turtlebasket/midi-controller/README.md

# Pocket Operator

## Contents

- [`device`](device/) - Board design files ([see README](device/README.md))
- [`firmware`](firmware/) - Device firmware ([see README](firmware/README.md))

## Gallery

| Completed Board (bird's eye) | Completed Board (top) |
| --- | --- |
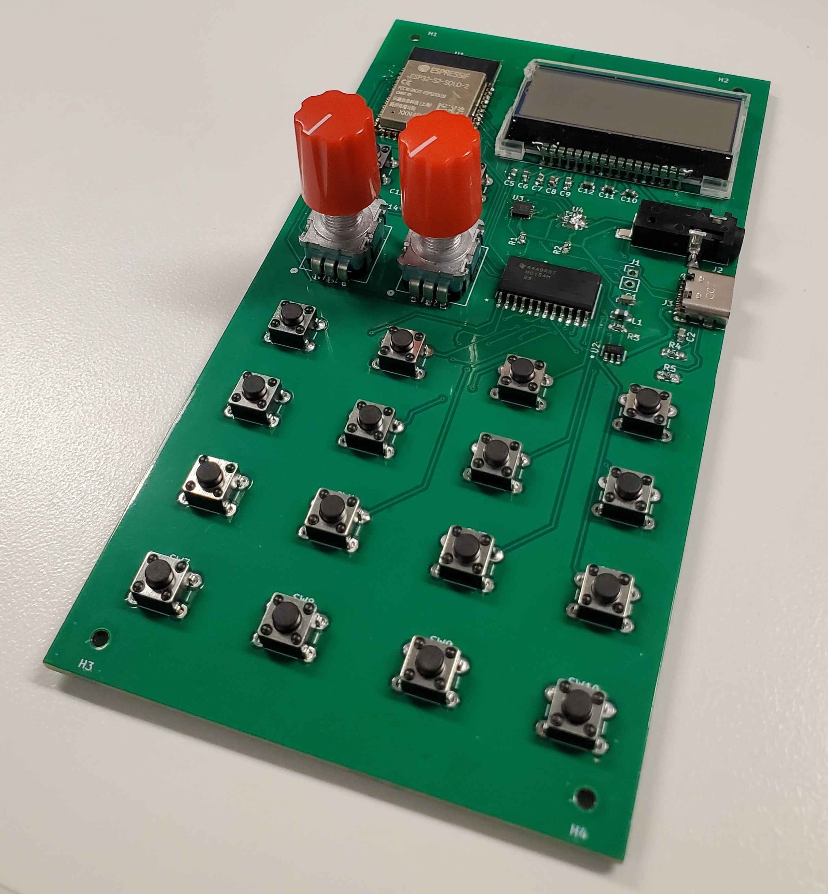
[picture p1: assets/finished-board.jpg]
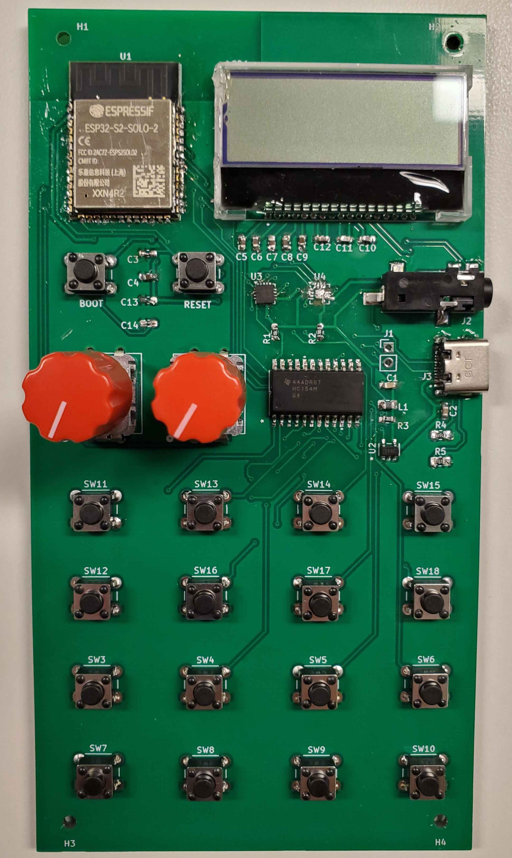
[picture p2: assets/finished-board-top.jpg]
|  |  | 

| Layout (Top) | Layout (Bottom) | Layout (Full) |
| --- | --- | --- |
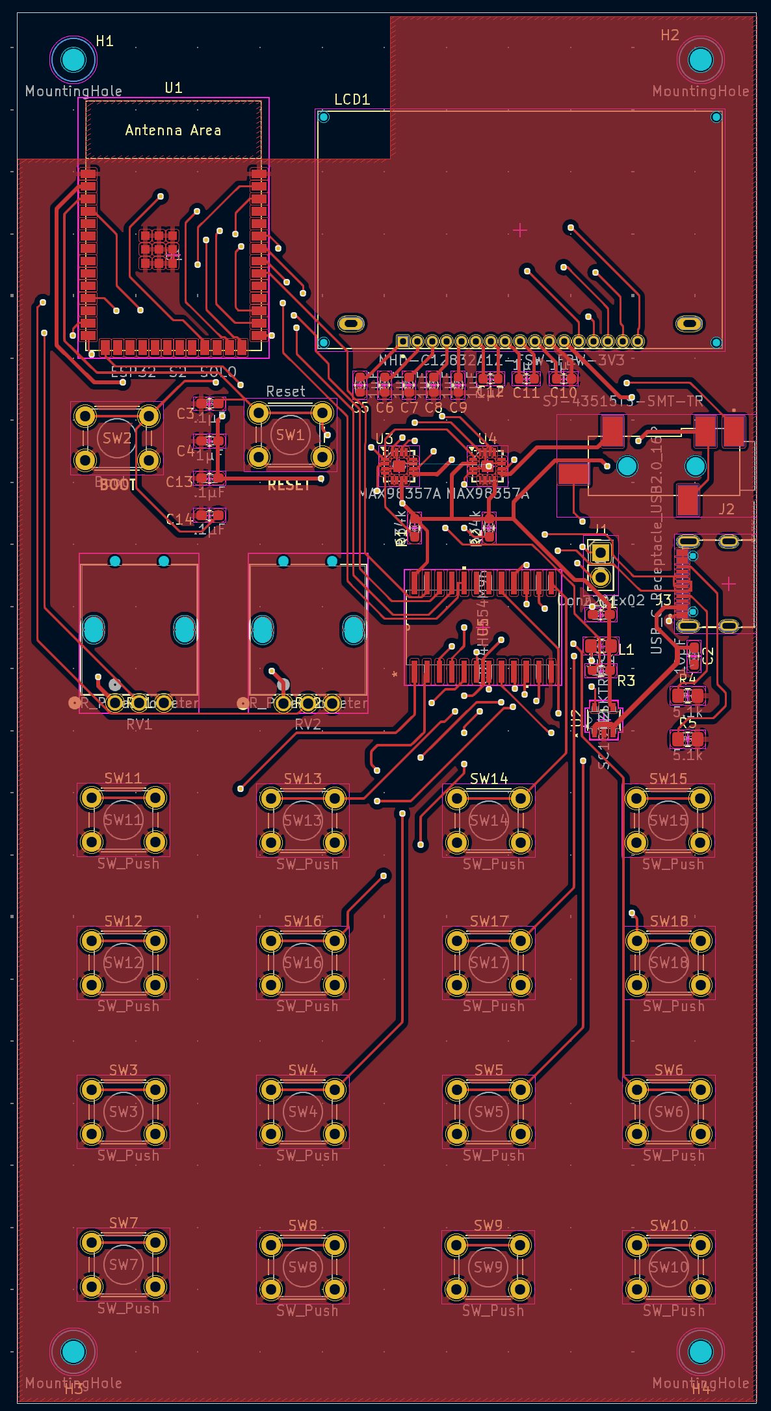
[picture p3: assets/layout-top.png]
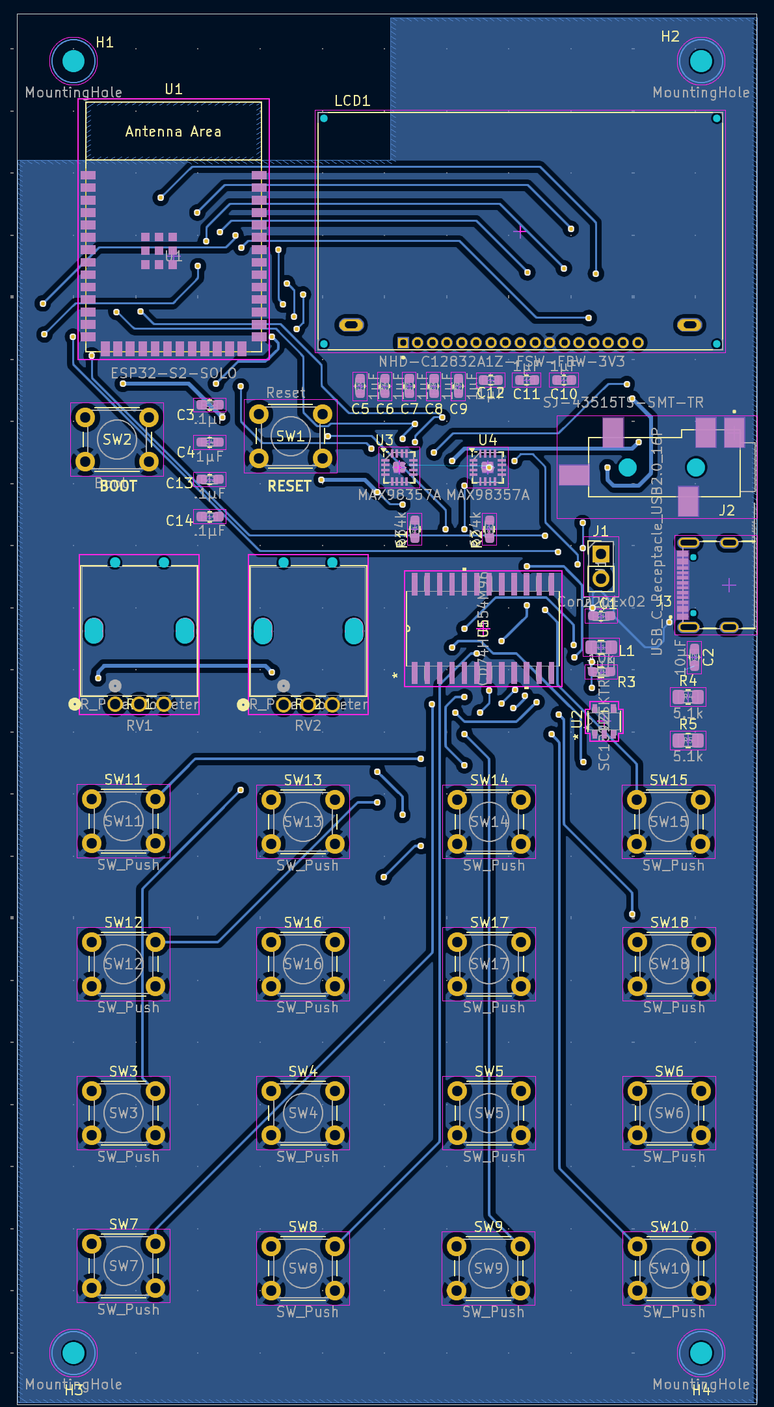
[picture p4: assets/layout-bottom.png]
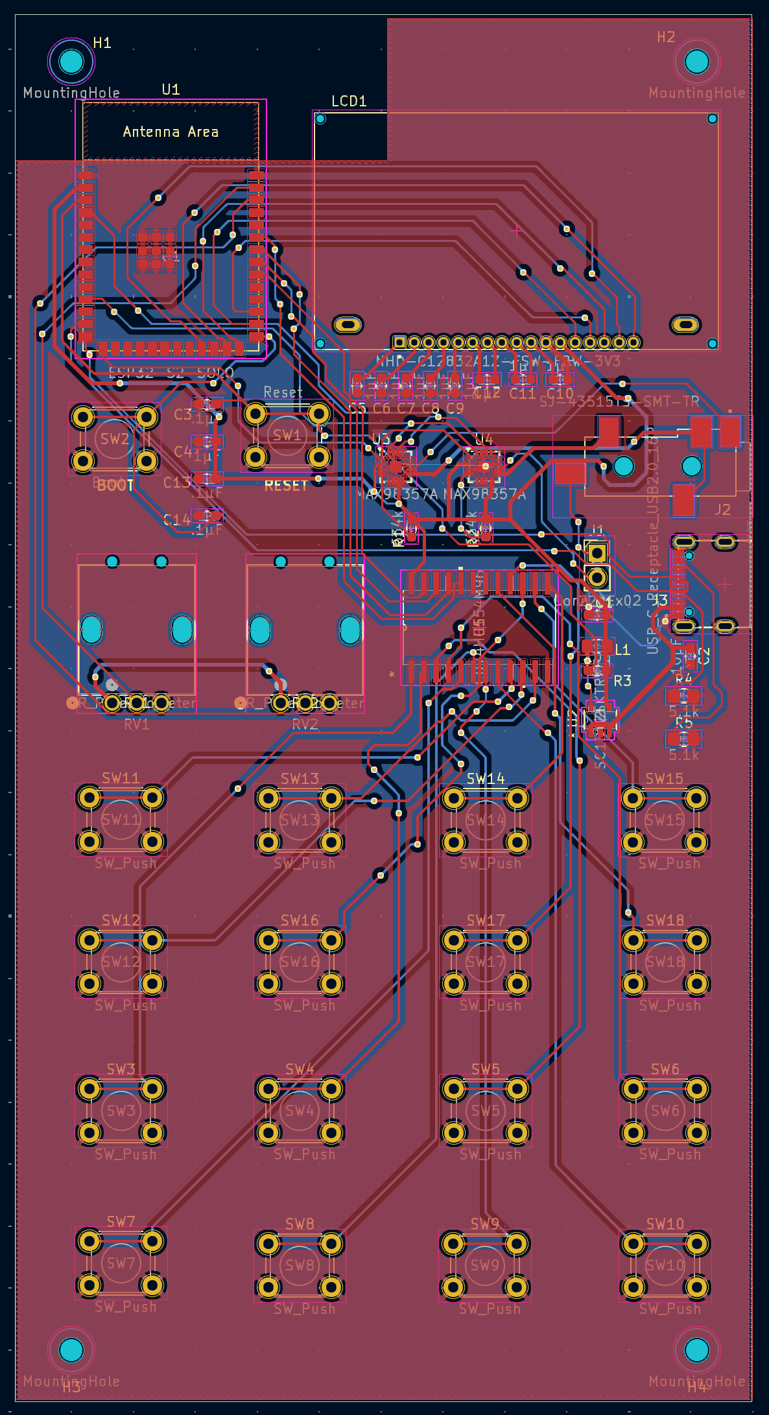
[picture p5: assets/layout-full.png]
|  |  |  |

| Schematic |
| --------- |
