turtlebasket/midi-controller/device/README.md

# Pocket Operator PCB Design Files

## Required KiCad Libraries

Must install:

- [Digikey Library](https://www.digikey.com/en/resources/design-tools/kicad) ([GitHub](https://github.com/Digi-Key/digikey-kicad-library))
- [Espressif Library (v3.0.1)](https://github.com/espressif/kicad-libraries/releases/tag/3.0.1)
