turtlebasket/midi-controller/device/parts/USB4105-GF-A/USB4105-GF-A.step

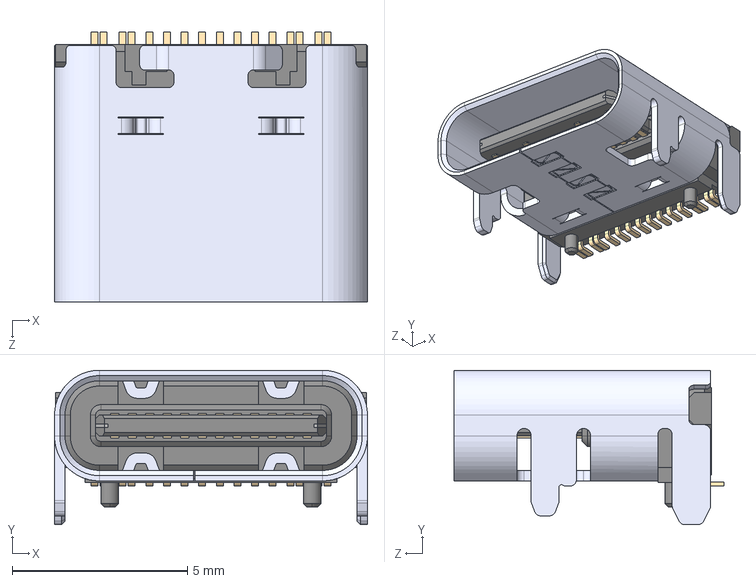
[picture p6: CAD file, 2024-11-02]
device/parts/USB4105-GF-A/USB4105-GF-A.step
8.94 x 4.41 x 7.71 mm
