turtlebasket/midi-controller/device/device.kicad_pcb

## KiCad design device/device.kicad_pcb (2024-11-08)

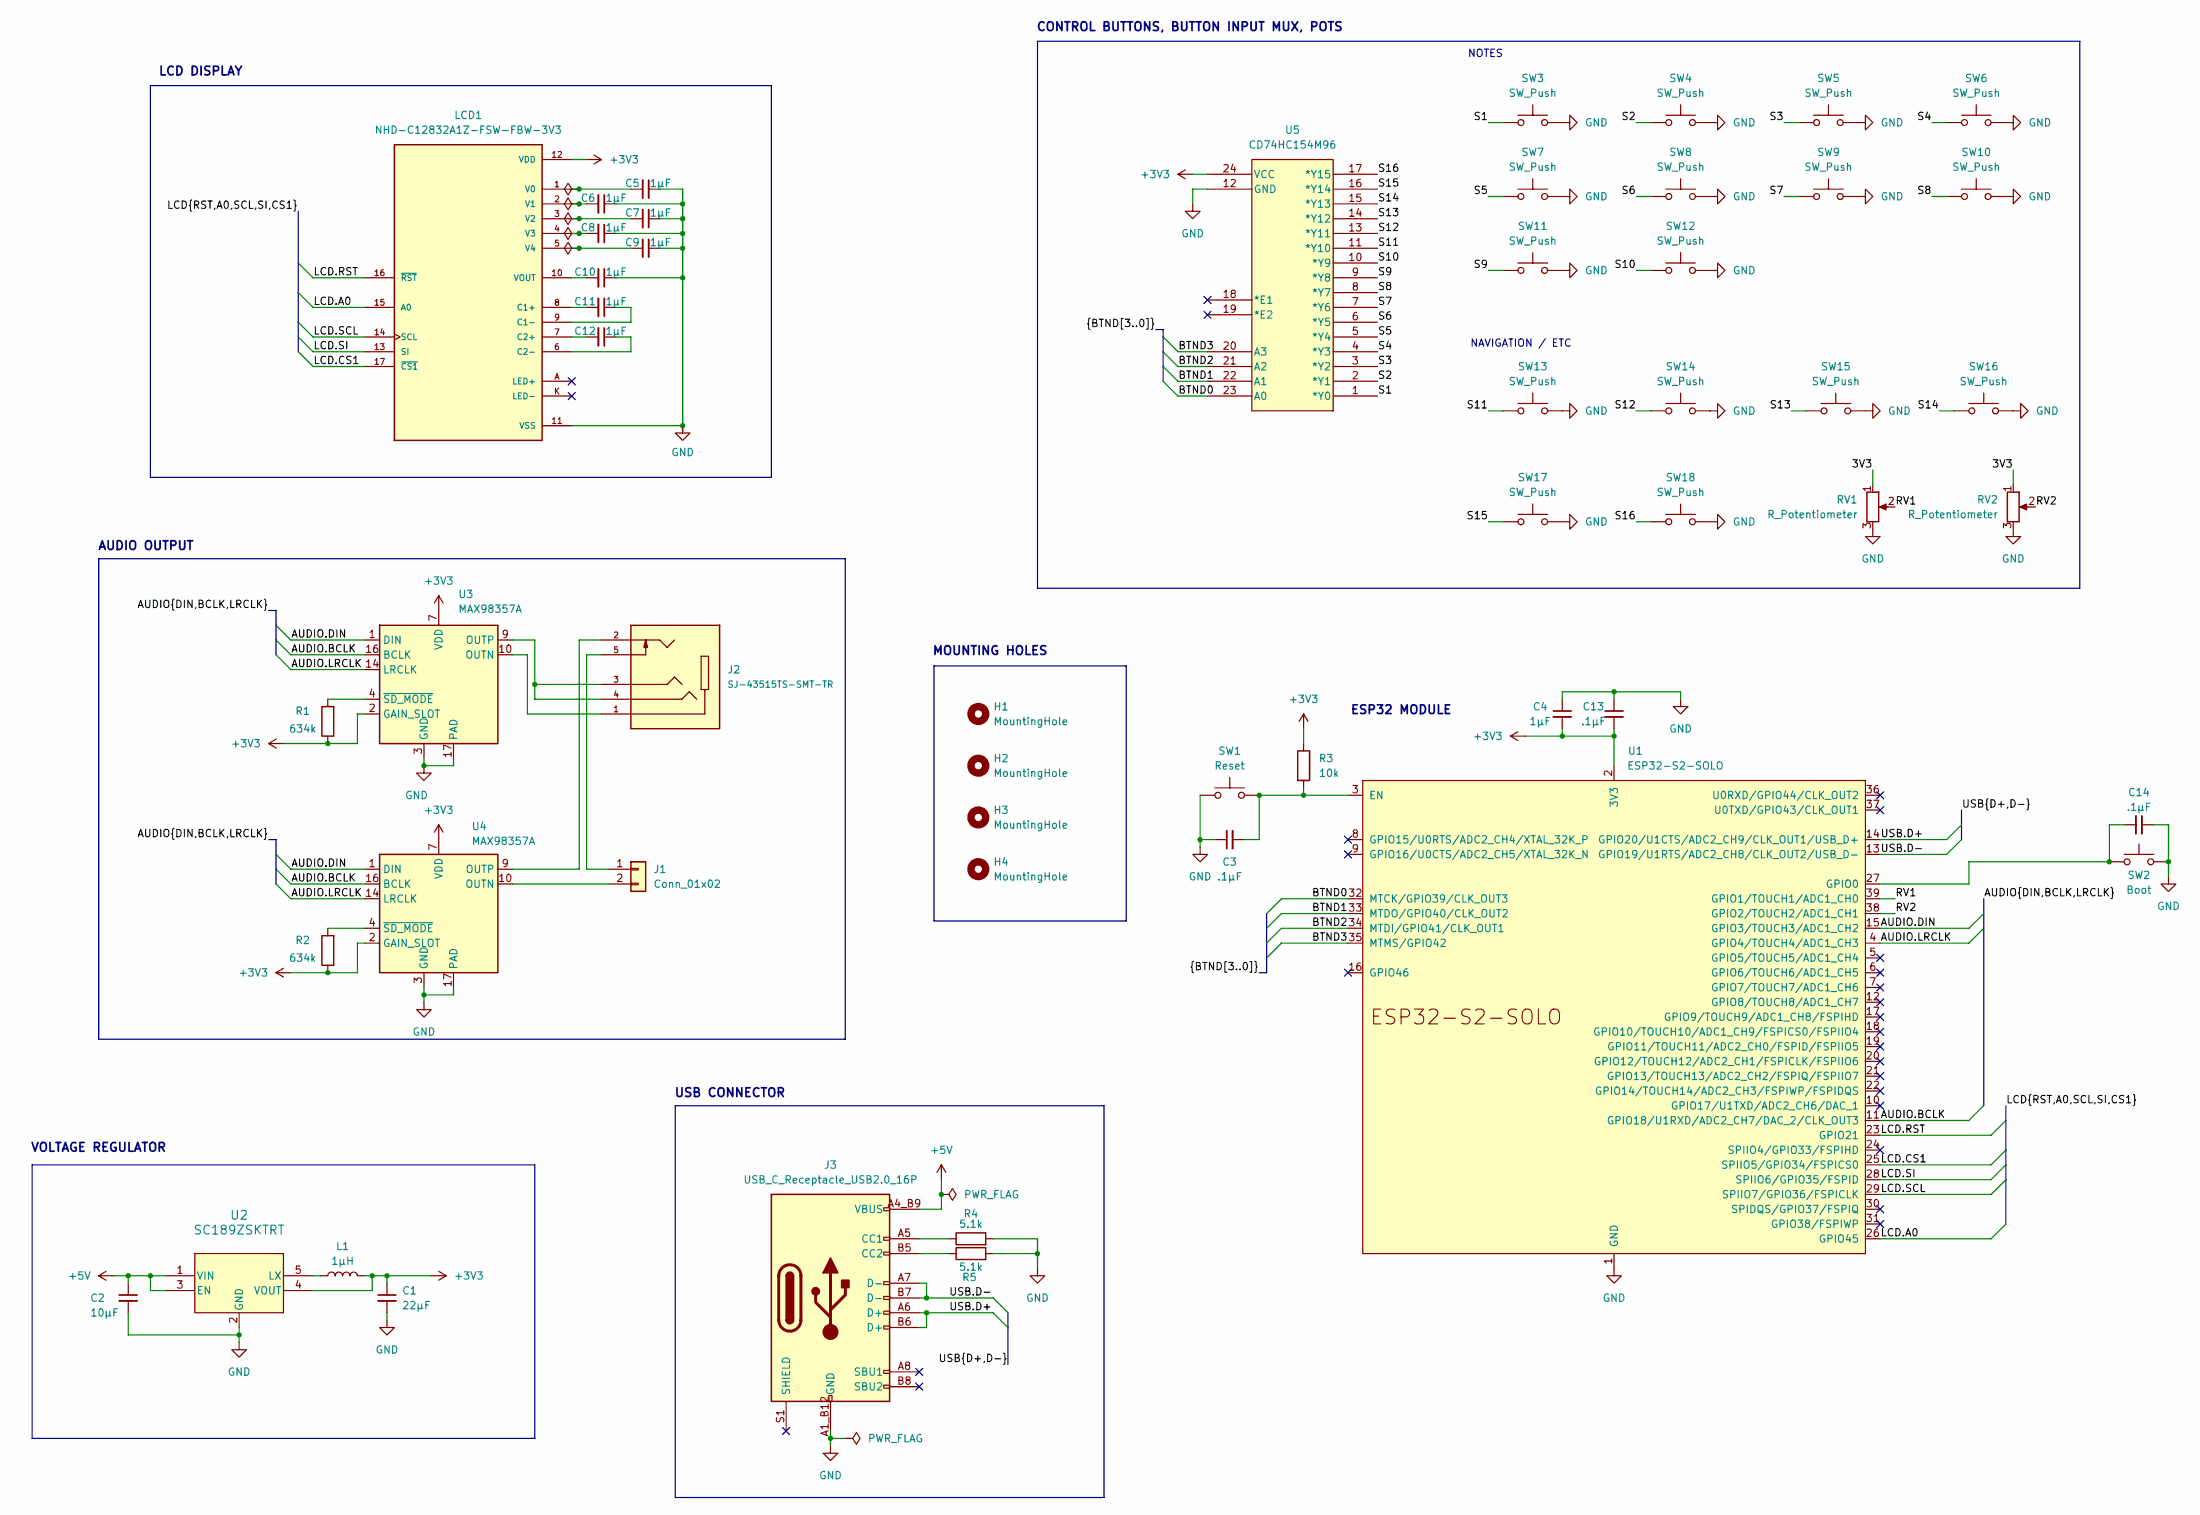
[picture p7: schematic device.kicad_sch]

Parts:
C1: 22µF; C_0603_1608Metric_Pad1.08x0.95mm_HandSolder
C2: 10µF; C_0603_1608Metric_Pad1.08x0.95mm_HandSolder
C3, C13, C14: .1µF; C_0603_1608Metric_Pad1.08x0.95mm_HandSolder
C4: 1µF; C_0603_1608Metric_Pad1.08x0.95mm_HandSolder
C5, C6, C7, C8, C9, C10, C11, C12: 1µF; C_0603_1608Metric
H1, H2, H3, H4: MountingHole; MountingHole_2.2mm_M2
J1: Conn_01x02; PinHeader_1x02_P2.54mm_Vertical
J2: SJ-43515TS-SMT-TR; CUI_SJ-43515TS-SMT-TR; PARTREV 1.05
J3: USB_C_Receptacle_USB2.0_16P; GCT_USB4105-GF-A
L1: 1µH; L_0805_2012Metric_Pad1.15x1.40mm_HandSolder
LCD1: NHD-C12832A1Z-FSW-FBW-3V3; LCD_NHD-C12832A1Z-FSW-FBW-3V3; PARTREV 7
R1, R2: 634k; R_0603_1608Metric_Pad0.98x0.95mm_HandSolder
R3: 10k; R_0603_1608Metric_Pad0.98x0.95mm_HandSolder
R4, R5: 5.1k; R_0805_2012Metric_Pad1.20x1.40mm_HandSolder
RV1, RV2: R_Potentiometer; POT_PRS11R-4-S_BRN
SW1: Reset; SW_PUSH_6mm_H5mm
SW2: Boot; SW_PUSH_6mm_H5mm
SW3, SW4, SW5, SW6, SW7, SW8, SW9, SW10, SW11, SW12, SW13, SW14, SW15, SW16, SW17, SW18: SW_Push; SW_PUSH_6mm_H5mm
U1: ESP32-S2-SOLO
U2: SC189ZSKTRT; SOT23-5-SC189_SEM
U3, U4: MAX98357A; TQFN-16-1EP_3x3mm_P0.5mm_EP1.23x1.23mm
U5: CD74HC154M96; DW24

Connections:
+3V3: C1.1, C4.2, C13.2, L1.2, LCD1.12 (VDD), R1.1, R2.1, R3.1, U1.2 (3V3), U2.4 (VOUT), U3.2 (GAIN_SLOT), U3.7 (VDD), U3.8 (VDD), U4.2 (GAIN_SLOT), U4.7 (VDD), U4.8 (VDD), U5.24 (VCC)
+5V: C2.1, J3.A4_B9 (VBUS), J3.A9 (VBUS), J3.B4 (VBUS), J3.B9 (VBUS), U2.1 (VIN), U2.3 (EN)
/3V3: RV1.1, RV2.1
/AUDIO.BCLK: U1.11 (GPIO18/U1RXD/ADC2_CH7/DAC_2/CLK_OUT3), U3.16 (BCLK), U4.16 (BCLK)
/AUDIO.DIN: U1.15 (GPIO3/TOUCH3/ADC1_CH2), U3.1 (DIN), U4.1 (DIN)
/AUDIO.LRCLK: U1.4 (GPIO4/TOUCH4/ADC1_CH3), U3.14 (LRCLK), U4.14 (LRCLK)
/BTND0: U1.32 (MTCK/GPIO39/CLK_OUT3), U5.23 (A0)
/BTND1: U1.33 (MTDO/GPIO40/CLK_OUT2), U5.22 (A1)
/BTND2: U1.34 (MTDI/GPIO41/CLK_OUT1), U5.21 (A2)
/BTND3: U1.35 (MTMS/GPIO42), U5.20 (A3)
/LCD.A0: LCD1.15 (A0), U1.26 (GPIO45)
/LCD.CS1: LCD1.17 (~CS1), U1.25 (SPIIO5/GPIO34/FSPICS0)
/LCD.RST: LCD1.16 (~RST), U1.23 (GPIO21)
/LCD.SCL: LCD1.14 (SCL), U1.29 (SPIIO7/GPIO36/FSPICLK)
/LCD.SI: LCD1.13 (SI), U1.28 (SPIIO6/GPIO35/FSPID)
/RV1: RV1.2, U1.39 (GPIO1/TOUCH1/ADC1_CH0)
/RV2: RV2.2, U1.38 (GPIO2/TOUCH2/ADC1_CH1)
/S1: SW3.1, U5.1 (*Y0)
/S2: SW4.1, U5.2 (*Y1)
/S3: SW5.1, U5.3 (*Y2)
/S4: SW6.1, U5.4 (*Y3)
/S5: SW7.1, U5.5 (*Y4)
/S6: SW8.1, U5.6 (*Y5)
/S7: SW9.1, U5.7 (*Y6)
/S8: SW10.1, U5.8 (*Y7)
/S9: SW11.1, U5.9 (*Y8)
/S10: SW12.1, U5.10 (*Y9)
/S11: SW13.1, U5.11 (*Y10)
/S12: SW14.1, U5.13 (*Y11)
/S13: SW15.1, U5.14 (*Y12)
/S14: SW16.1, U5.15 (*Y13)
/S15: SW17.1, U5.16 (*Y14)
/S16: SW18.1, U5.17 (*Y15)
/USB.D+: J3.A6 (D+), J3.B6 (D+), U1.14 (GPIO20/U1CTS/ADC2_CH9/CLK_OUT1/USB_D+)
/USB.D-: J3.A7 (D-), J3.B7 (D-), U1.13 (GPIO19/U1RTS/ADC2_CH8/CLK_OUT2/USB_D-)
GND: C1.2, C2.2, C3.1, C4.1, C5.1, C6.1, C7.1, C8.1, C9.1, C10.1, C13.1, C14.1, J3.A1_B12 (GND), J3.A12 (GND), J3.B1 (GND), J3.B12 (GND), LCD1.11 (VSS), R4.2, R5.2, RV1.3, RV2.3, SW1.1, SW2.2, SW3.2, SW4.2, SW5.2, SW6.2, SW7.2, SW8.2, SW9.2, SW10.2, SW11.2, SW12.2, SW13.2, SW14.2, SW15.2, SW16.2, SW17.2, SW18.2, U1.1 (GND), U1.40 (GND), U1.41 (GND), U2.2 (GND), U3.3 (GND), U3.11 (GND), U3.15 (GND), U3.17 (PAD), U4.3 (GND), U4.11 (GND), U4.15 (GND), U4.17 (PAD), U5.12 (GND)
unnamed: J1.1, J2.5
unnamed: J1.2, U4.10 (OUTN)
unnamed: J3.A5 (CC1), R4.1
unnamed: J3.B5 (CC2), R5.1
unnamed: C11.2, LCD1.8 (C1+)
unnamed: C11.1, LCD1.9 (C1-)
unnamed: C12.2, LCD1.7 (C2+)
unnamed: C12.1, LCD1.6 (C2-)
unnamed: C5.2, LCD1.1 (V0)
unnamed: C6.2, LCD1.2 (V1)
unnamed: C7.2, LCD1.3 (V2)
unnamed: C8.2, LCD1.4 (V3)
unnamed: C9.2, LCD1.5 (V4)
unnamed: C10.2, LCD1.10 (VOUT)
unnamed: C3.2, R3.2, SW1.2, U1.3 (EN)
unnamed: C14.2, SW2.1, U1.27 (GPIO0)
unnamed: L1.1, U2.5 (LX)
unnamed: J2.1, U3.10 (OUTN)
unnamed: J2.3, J2.4, U3.9 (OUTP)
unnamed: R1.2, U3.4 (~SD_MODE)
unnamed: J2.2, U4.9 (OUTP)
unnamed: R2.2, U4.4 (~SD_MODE)

Notes on the sheet:
VOLTAGE REGULATOR
CONTROL BUTTONS, BUTTON INPUT MUX, POTS
AUDIO OUTPUT
MOUNTING HOLES
USB CONNECTOR
NOTES
ESP32 MODULE
NAVIGATION / ETC
LCD DISPLAY

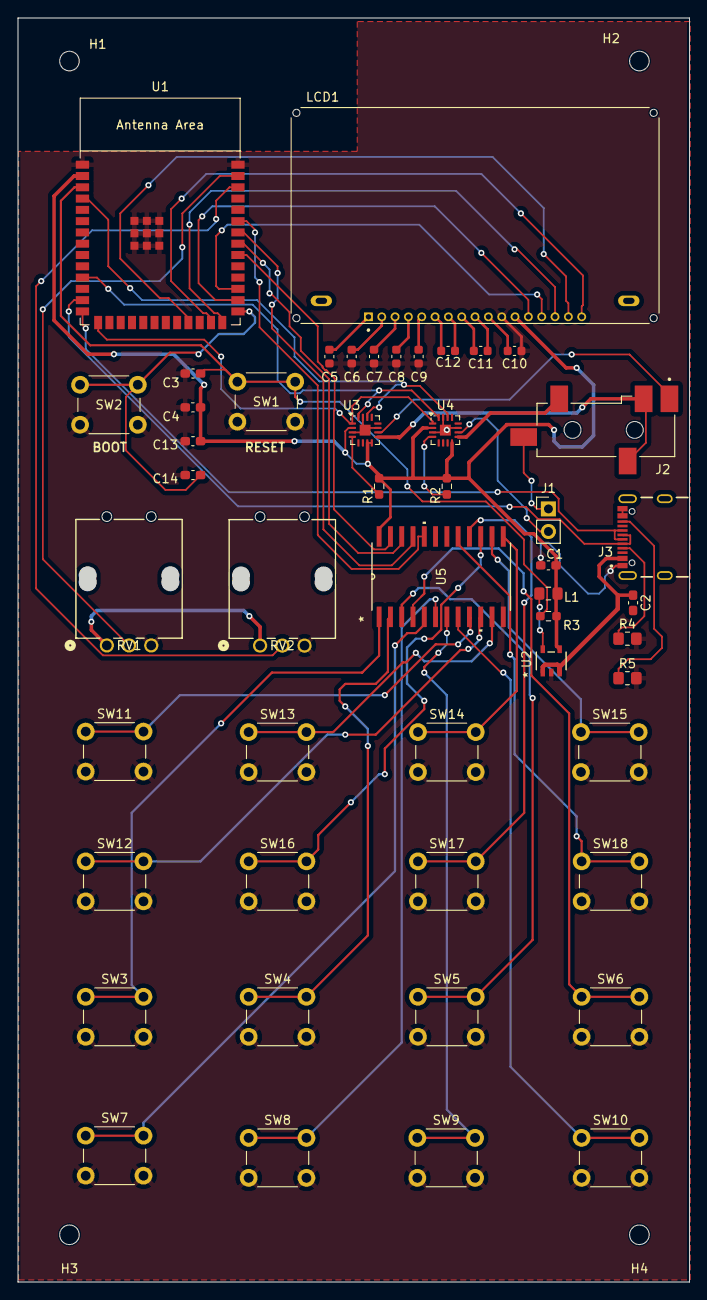
[picture p8: board device.kicad_pcb from above]

Board: 2 copper layers, 75.6 x 142.2 mm, 53 parts (0 on the bottom side), 58 nets.
