turtlebasket/midi-controller/(threads)

Thread 7 (2024-10-30):

New voltage regulator & passives (schematic)

turtlebasket, 2024-10-30:
Switch from LTC1624 to single-mode buck converter (5V->3.3V), must support  & choose new set of passives

Closed 2024-11-05.
