turtlebasket/midi-controller/(commit log)

2024-10-18 add kicad ignores
2024-10-18 move kicad ignore / ignore backups
2024-10-18 remove midi/midi.kicad_prl
2024-10-18 update esp32 from s2 to s3
    [ESP32-S3.step]
2024-10-18 use esp32-s3-wroom
    [ESP32-S3.step]
2024-10-18 button/potentiometer layout
    [midi.kicad_sch]
2024-10-18 add vreg schematic symbol
2024-10-19 added LTC1624 symbol, button layout, working on voltage reg
    [midi.kicad_sch]
2024-10-19 finished voltage regulator
    [midi.kicad_sch]
2024-10-19 page size increase and loaded screen
    [midi.kicad_sch]
2024-10-20 schematic: link up audio i2s & LCD SPI bus
    [midi.kicad_sch]
2024-10-21 add button input mux
    [midi.kicad_sch]
2024-10-21 remove old voltage regulator
2024-10-30 added footprints for caps and some others
    [midi.kicad_sch]
2024-10-30 downloaded mosfet footprint, tried to import footprint libs but failed
2024-10-30 downloaded L1 footprint
    [midi.kicad_sch]
2024-10-30 can't get footprint import to work
    [midi.kicad_sch]
2024-10-30 unfuck footprint assignments / significant progress on layout
    [midi.kicad_pcb, midi.kicad_sch]
2024-10-30 switch esp32 from s3 to s2 / use esplib, use USBC data connector, other tweaks
    [midi.kicad_pcb, midi.kicad_sch]
2024-10-31 wip: switch from LTC1624 to other vreg
    [midi.kicad_sch]
2024-10-31 new vreg
    [midi.kicad_sch]
2024-10-31 assign more footprints
    [midi.kicad_pcb, midi.kicad_sch]
2024-11-02 layout progress
    [USB4105-GF-A.step, midi.kicad_pcb, midi.kicad_sch]
2024-11-03 fix some layout issues
    [midi.kicad_pcb]
2024-11-05 slight ERC fixes for gnd/power in
    [midi.kicad_sch]
2024-11-07 fix all ERC issues
    [midi.kicad_sch]
2024-11-07 move power flag
    [midi.kicad_sch]
2024-11-07 fixed ~60 clearance errors around LCD area
    [midi.kicad_pcb]
2024-11-08 more DRC fixes
    [midi.kicad_pcb]
2024-11-08 add mounting holes, slight fixes, redo pours
    [midi.kicad_pcb, midi.kicad_sch]
2024-11-08 close to finished
    [midi.kicad_pcb]
2024-11-09 rename pcb project
    [USB4105-GF-A.step, device.kicad_pcb, device.kicad_sch]
